DavidEnds/cuteBot/cuteBot.kicad_pcb

## KiCad design cuteBot.kicad_pcb (2019-03-10)

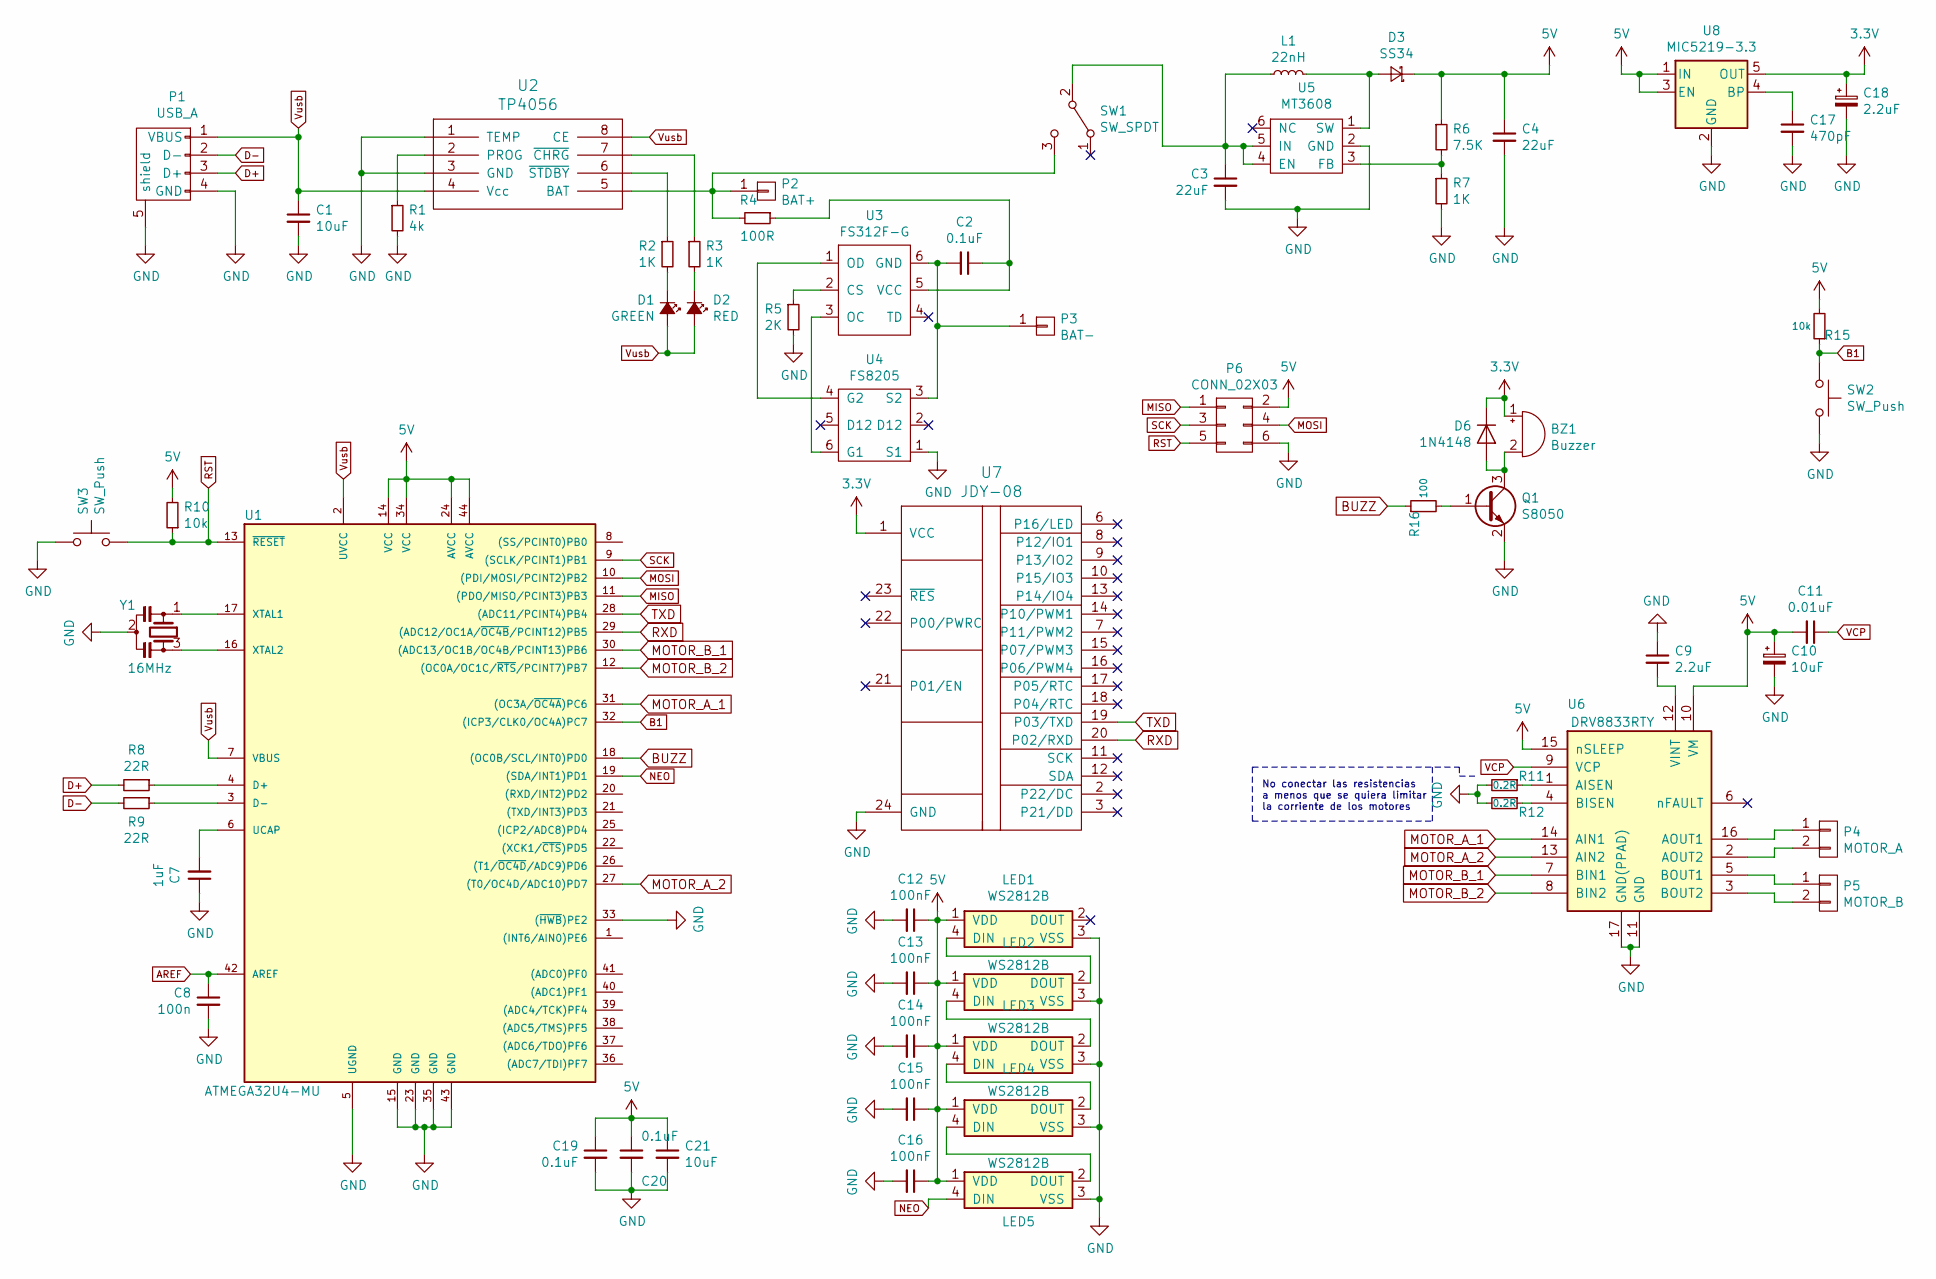
[picture p1: schematic cuteBot.sch]

Parts:
BZ1: Buzzer; Buzzer-7.5x7.5mm
C1, C10, C21: 10uF; C_0603
C2, C19, C20: 0.1uF; C_0603
C3, C4: 22uF; C_1812
C7: 1uF; C_0603
C8: 100n; C_0603
C9, C18: 2.2uF; C_0603
C11: 0.01uF; C_0603
C12, C13, C14, C15, C16: 100nF; C_0603
C17: 470pF; C_0603
D1: GREEN; LED_0603
D2: RED; LED_0603
D3: SS34; D_SMA
D6: 1N4148; D_MicroMELF
L1: 22nH; L_7.3x7.3_H4.5
LED1, LED2, LED3, LED4, LED5: WS2812B; LED_SK6812MINI_PLCC4_3.5x3.5mm_P1.75mm
P1: USB_A; USB_Micro-B_Molex-105017-0001
P2: BAT+; Test_Point_Pad_d1.0mm
P3: BAT-; Test_Point_Pad_d1.0mm
P4: MOTOR_A; SMD_2pin_Solderpad
P5: MOTOR_B; SMD_2pin_Solderpad
P6: CONN_02X03; 2X3_SMT_POSTS
Q1: S8050; SOT-23
R1: 4k; R_0603
R2, R3, R7: 1K; R_0603
R4: 100R; R_0603
R5: 2K; R_0603
R6: 7.5K; R_0603
R8, R9: 22R; R_0603
R10, R15: 10k; R_0603
R11, R12: 0.2R; R_0603
R16: 100; R_0603
SW1: SW_SPDT; SW_SPDT_PCM12
SW2, SW3: SW_Push; SW_SPST_B3U-3000P
U1: ATMEGA32U4-MU; QFN-44-1EP_7x7mm_Pitch0.5mm
U2: TP4056; HTSOP-8-1EP_3.9x4.9mm_Pitch1.27mm_ThermalVias
U3: FS312F-G; SOT-23-6
U4: FS8205; SOT-23-6
U5: MT3608; SOT-23-6
U6: DRV8833RTY; WQFN-16-1EP_4x4mm_Pitch0.65mm
U7: JDY-08
U8: MIC5219-3.3; SOT-23-5
Y1: 16MHz; RESONATOR-SMD-3.2X1.3

Connections:
3.3V: BZ1.1 (-), C18.1, D6.1 (K), U7.1 (VCC), U8.5 (OUT)
5V: C4.1, C10.1, C11.2, C12.1, C13.1, C14.1, C15.1, C16.1, C19.1, C20.1, C21.1, D3.1 (K), LED1.1 (VDD), LED2.1 (VDD), LED3.1 (VDD), LED4.1 (VDD), LED5.1 (VDD), P6.2, R6.1, R10.2, R15.2, U1.14 (VCC), U1.24 (AVCC), U1.34 (VCC), U1.44 (AVCC), U6.10 (VM), U6.15 (nSLEEP), U8.1 (IN), U8.3 (EN)
AREF: C8.1, U1.42 (AREF)
B1: R15.1, SW2.1, U1.32 ((ICP3/CLK0/OC4A)PC7)
BUZZ: R16.1, U1.18 ((OC0B/SCL/INT0)PD0)
D+: P1.3 (D+), R8.2
D-: P1.2 (D-), R9.2
GND: C1.2, C3.2, C4.2, C7.1, C8.2, C9.1, C10.2, C12.2, C13.2, C14.2, C15.2, C16.2, C17.2, C18.2, C19.2, C20.2, C21.2, LED1.3 (VSS), LED2.3 (VSS), LED3.3 (VSS), LED4.3 (VSS), LED5.3 (VSS), P1.4 (GND), P1.5 (shield), P6.6, Q1.2 (E), R1.2, R5.2, R7.2, R11.2, R12.2, SW2.2, SW3.1, U1.5 (UGND), U1.15 (GND), U1.23 (GND), U1.33 ((~HWB~)PE2), U1.35 (GND), U1.43 (GND), U2.1 (TEMP), U2.3 (GND), U4.1 (S1), U5.2 (GND), U6.11 (GND), U6.17 (GND(PPAD)), U7.24 (GND), U8.2 (GND), Y1.2
MISO: P6.1, U1.11 ((PDO/MISO/PCINT3)PB3)
MOSI: P6.4, U1.10 ((PDI/MOSI/PCINT2)PB2)
MOTOR_A_1: U1.31 ((OC3A/~OC4A~)PC6), U6.14 (AIN1)
MOTOR_A_2: U1.27 ((T0/OC4D/ADC10)PD7), U6.13 (AIN2)
MOTOR_B_1: U1.30 ((ADC13/OC1B/OC4B/PCINT13)PB6), U6.7 (BIN1)
MOTOR_B_2: U1.12 ((OC0A/OC1C/~RTS~/PCINT7)PB7), U6.8 (BIN2)
NEO: LED5.4 (DIN), U1.19 ((SDA/INT1)PD1)
unnamed: BZ1.2 (+), D6.2 (A), Q1.3 (C)
unnamed: C2.1, R4.1, U3.5 (VCC)
unnamed: C2.2, P3.1, U3.6 (GND), U4.3 (S2)
unnamed: C3.1, L1.1, SW1.2 (B), U5.4 (EN), U5.5 (IN)
unnamed: C7.2, U1.6 (UCAP)
unnamed: C9.2, U6.12 (VINT)
unnamed: C17.1, U8.4 (BP)
unnamed: D1.1 (K), R2.2
unnamed: D2.1 (K), R3.2
unnamed: D3.2 (A), L1.2, U5.1 (SW)
unnamed: LED1.4 (DIN), LED2.2 (DOUT)
unnamed: LED2.4 (DIN), LED3.2 (DOUT)
unnamed: LED3.4 (DIN), LED4.2 (DOUT)
unnamed: LED4.4 (DIN), LED5.2 (DOUT)
unnamed: P2.1, R4.2, SW1.3 (C), U2.5 (BAT)
unnamed: P4.1, U6.16 (AOUT1)
unnamed: P4.2, U6.2 (AOUT2)
unnamed: P5.1, U6.5 (BOUT1)
unnamed: P5.2, U6.3 (BOUT2)
unnamed: Q1.1 (B), R16.2
unnamed: R1.1, U2.2 (PROG)
unnamed: R2.1, U2.6 (~STDBY)
unnamed: R3.1, U2.7 (~CHRG)
unnamed: R5.1, U3.2 (CS)
unnamed: R6.2, R7.1, U5.3 (FB)
unnamed: R8.1, U1.4 (D+)
unnamed: R9.1, U1.3 (D-)
unnamed: R11.1, U6.1 (AISEN)
unnamed: R12.1, U6.4 (BISEN)
unnamed: U1.16 (XTAL2), Y1.3
unnamed: U1.17 (XTAL1), Y1.1
unnamed: U3.1 (OD), U4.4 (G2)
unnamed: U3.3 (OC), U4.6 (G1)
RST: P6.5, R10.1, SW3.2, U1.13 (~RESET~)
RXD: U1.29 ((ADC12/OC1A/~OC4B~/PCINT12)PB5), U7.20 (P02/RXD)
SCK: P6.3, U1.9 ((SCLK/PCINT1)PB1)
TXD: U1.28 ((ADC11/PCINT4)PB4), U7.19 (P03/TXD)
VCP: C11.1, U6.9 (VCP)
Vusb: C1.1, D1.2 (A), D2.2 (A), P1.1 (VBUS), U1.2 (UVCC), U1.7 (VBUS), U2.4 (Vcc), U2.8 (CE)

Notes on the sheet:
No conectar las resistencias a menos que se quiera limitar la corriente de los motores

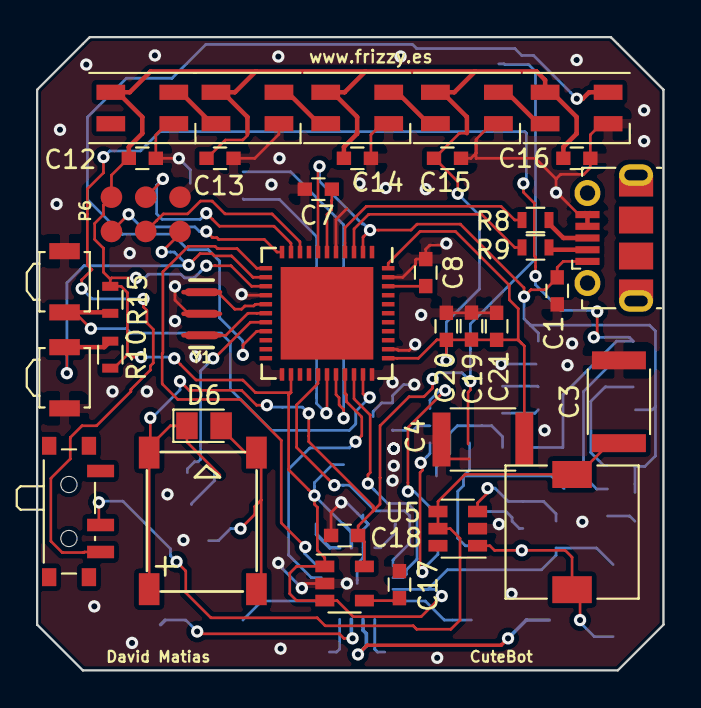
[picture p2: board cuteBot.kicad_pcb from above]

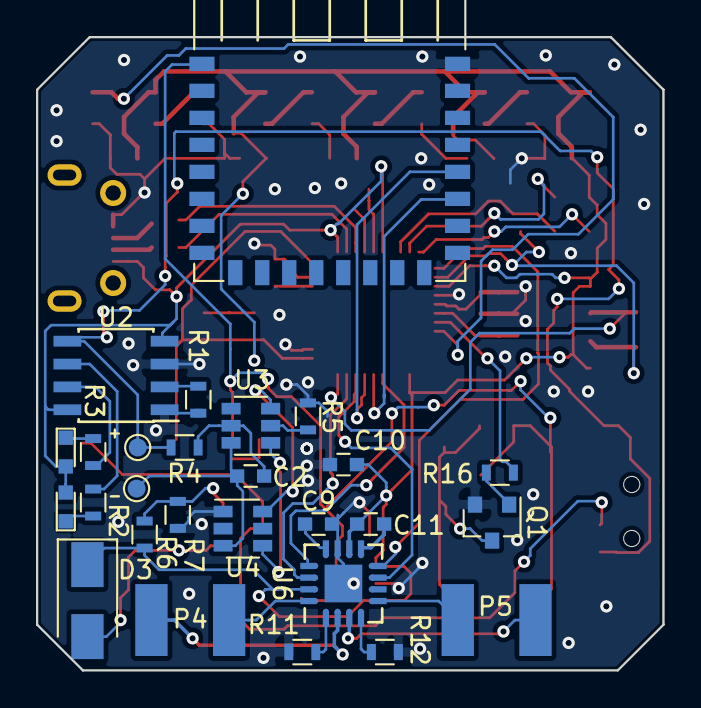
[picture p3: board cuteBot.kicad_pcb from below]

Board: 2 copper layers, 34.8 x 35.2 mm, 63 parts (27 on the bottom side), 54 nets.
