DavidEnds/cuteBot/(commit log)

2018-12-16 Esquema comenzado y simbolos propios creados
    [cuteBot-2018-12-16-19-04-18-2018-12-16-21-10-59.sch, cuteBot-2018-12-16-19-04-18.sch, cuteBot.kicad_pcb, cuteBot.sch]
2019-01-02 Añadidos algunos componentes principales
    Añadidos los leds. puente en H y pulsador.
    [cuteBot.sch]
2019-02-11 Añadiendo los componentes, hay algunos errores de footprint
    [cuteBot.sch]
2019-02-11 Footprints correctos
    [cuteBot.kicad_pcb, cuteBot.sch]
2019-02-11 Error en el S8050 subsanado
    [cuteBot.kicad_pcb]
2019-02-11 Colocando los componentes
    [cuteBot.kicad_pcb, cuteBot.sch]
2019-02-17 Resonador cambiado
    [cuteBot.kicad_pcb, cuteBot.sch]
2019-02-17 Leds RX/TX eliminados
    [cuteBot.kicad_pcb, cuteBot.sch]
2019-02-17 Enrutado avanzando. 65 nets
    [cuteBot.kicad_pcb]
2019-02-18 26 nets restantes
    [cuteBot.kicad_pcb]
2019-02-18 Enrutado comleto
    [cuteBot.kicad_pcb]
2019-02-18 Colocando serigrafias
    [cuteBot.kicad_pcb]
2019-02-18 Serigrafía terminada
    [cuteBot.kicad_pcb]
2019-03-10 Errores corregidos.
    Vias que provocaban un corto, pinout del Q1 erróneo y flag de los neopixel no conectado al micro.
    [cuteBot.kicad_pcb, cuteBot.sch]
